pa3ang/ESP-WSPR/esp-wspr-calibration.JPG

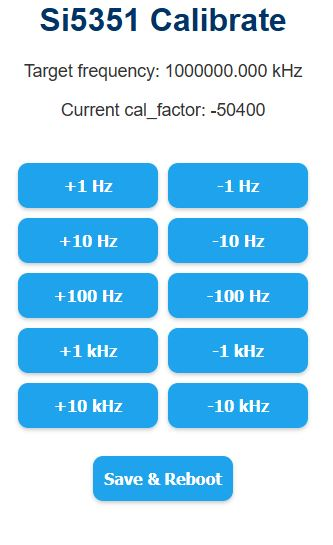
esp-wspr-calibration.JPG
