pa3ang/ESP-WSPR/PA3FEX Design/WSPR-FEX-V2.pdf

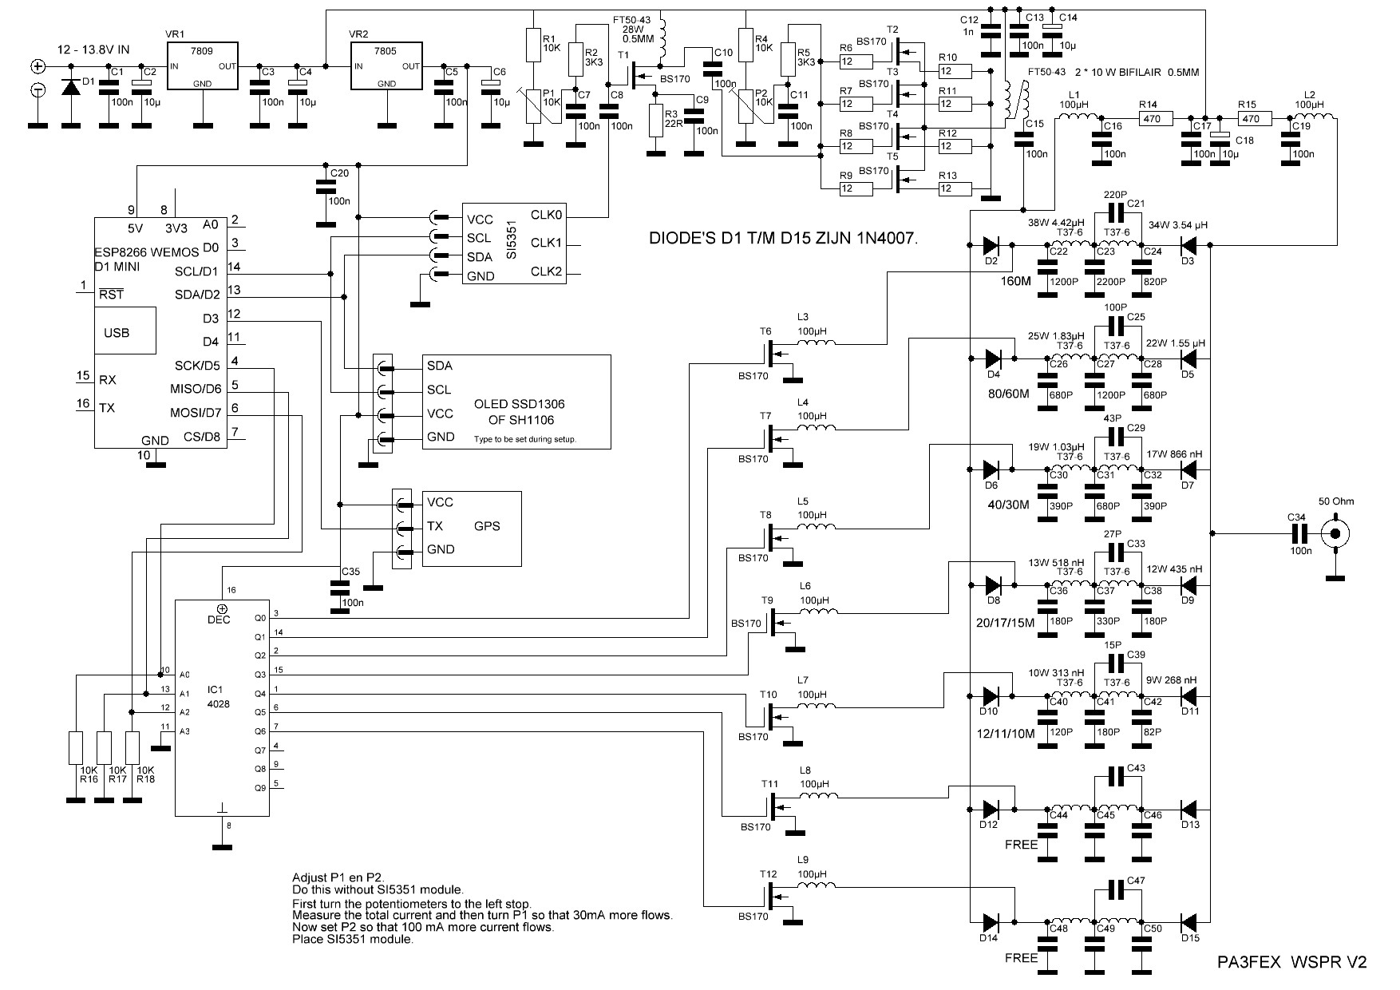
[picture p3: page 1]
