pa3ang/ESP-WSPR/esp-wspr-bandconfig.JPG

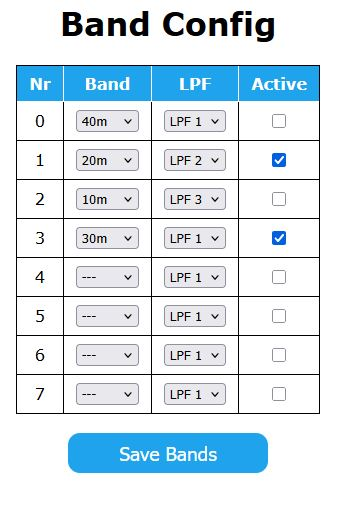
esp-wspr-bandconfig.JPG
