pa3ang/ESP-WSPR/esp-wspr-config.JPG

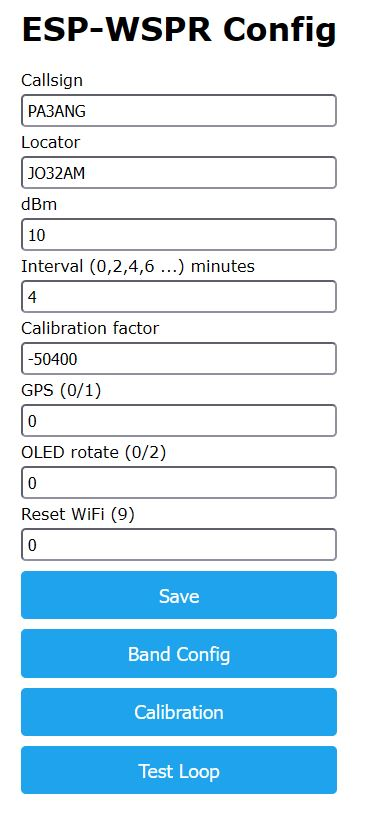
esp-wspr-config.JPG
