pa3ang/ESP-WSPR/PA3FEX Design/component wspr-v2.JPG

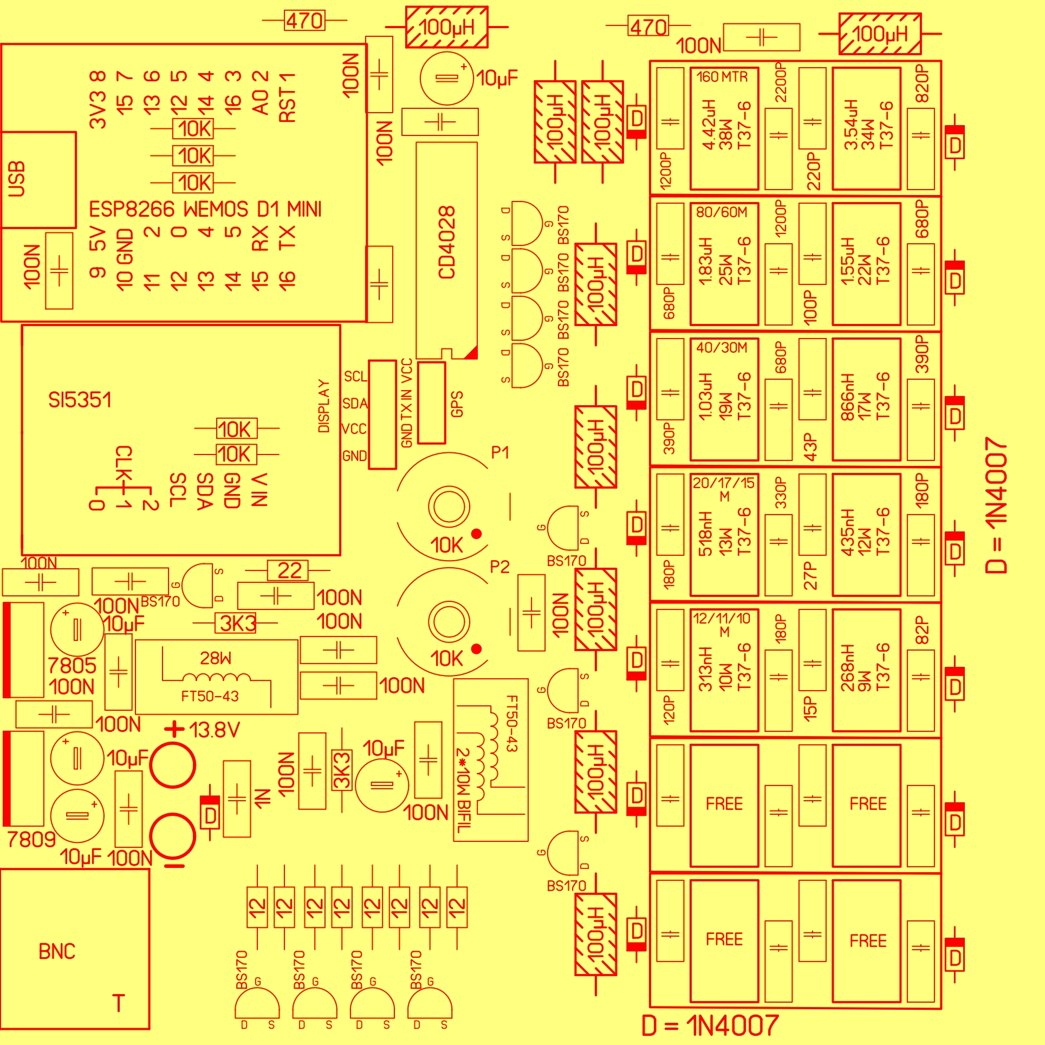
PA3FEX Design/component wspr-v2.JPG
