pa3ang/ESP-WSPR/PA3FEX Design/component- v2 bottem.JPG

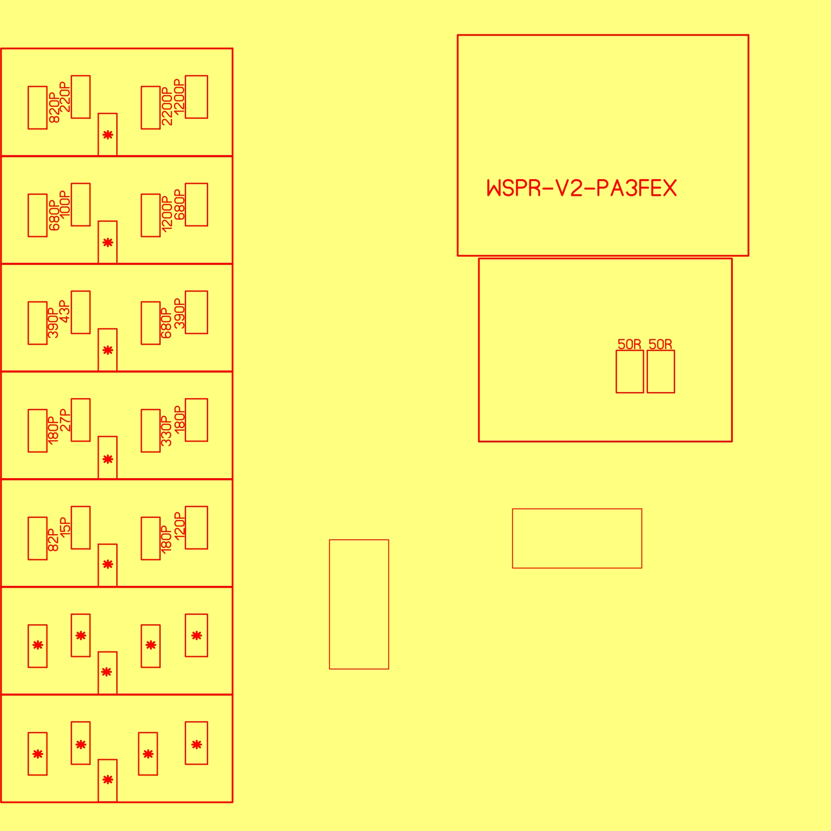
PA3FEX Design/component- v2 bottem.JPG
