pa3ang/ESP-WSPR/(commit log)

2025-10-03 Corrected library name, added more user config
    Maidenhed.h caused an issue on Arduino IDE and changed to maidenhed.h
    Added EEPROM garbisch check to load defaults
    Improved Calibartion html page with correct stylesheet
    Prohibit transmission when Callsign not set
    [ESP_WSPR_ANG_V1_1.ino]
2025-10-04 Add files via upload
    Corrected library name, added more user config
    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
    [ESP_WSPR_ANG_V1_1.ino]
2025-10-21 small improvements
    changes calibration literals
    improved initial connecting to TinyGPS
