pa3ang/ESP-WSPR/PA3FEX Design/WSPR-V2.jpg

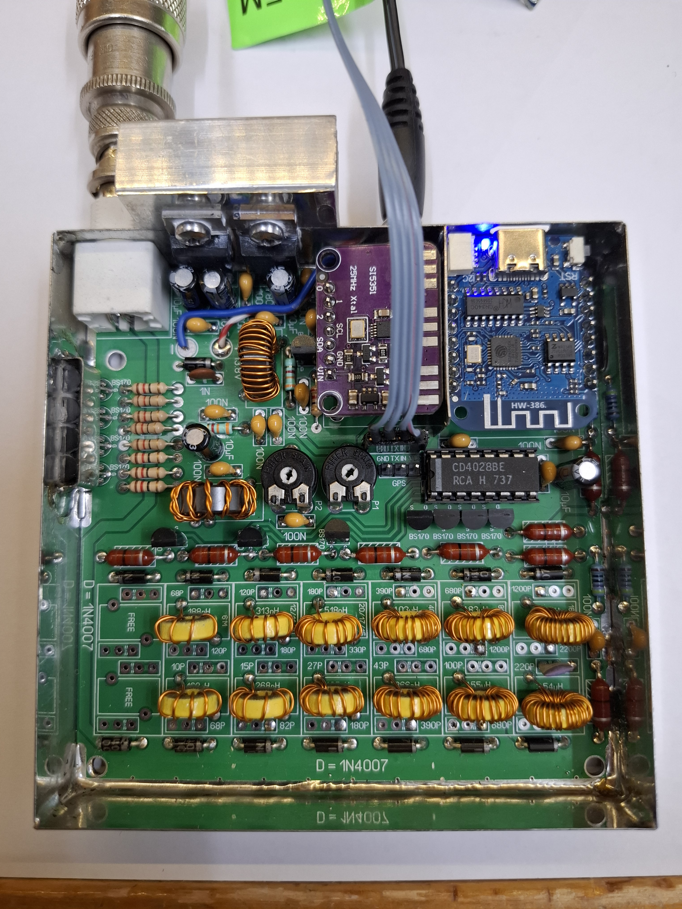
PA3FEX Design/WSPR-V2.jpg
